Tokoro0917/jansen-mouse/docs/design.md

# 設計資料

## 1. コンセプト

マイクロマウスは通常タイヤ走行ですが、本機はテオヤンセン機構の脚で歩きます。
速さではなく「脚で迷路を解く」ことが目標です。そのため設計方針は次の 3 点です。

1. **旋回するときだけ区画中心で止まる走行**。直進が続くあいだは止まらずに次の区画の壁を先読みし、
   曲がるときは区画中心で止まって前壁補正 → 超信地旋回する。最短走行では直線区間をまとめて走る。
2. **向きはジャイロ、距離はクランク回転数**。脚は横滑りするため車輪型のオドメトリ（左右差から角度）は使わない。
3. **超信地旋回**（左右のクランクを逆回転）。テオヤンセン機構はクランクを逆転すると足先軌跡を逆にたどるので後退・旋回が可能。

## 2. 脚機構

### 2.1 リンク寸法

Theo Jansen の Holy Numbers を縮尺 `s` [mm/unit] で縮小して使います。

| 項目 | Holy Numbers 基準 (s = 1) | 本機 (s = 0.40) |
|---|---|---|
| クランク半径 m | 15 | 6.0 mm |
| 1 本の足の接地区間の長さ | 53.1 | 21.2 mm |
| **1 回転あたりの胴体の前進量**（片側 3 スロー） | 136.1 | **54.4 mm** |
| 足上げ高さ | 22.5 | 9.0 mm |
| クランク中心の対地高さ | 91.8 | 36.7 mm |
| 接地区間の平坦度 | 0.67 | 0.27 mm |

全リンク長は [jansen_report.md](jansen_report.md) を参照（自動生成）。

### 2.2 組立クランク軸と積層順

リンク j, k は回転中にクランク中心 O の真上を通過するため、**脚の層を貫く通し軸は置けません**。
そこで 1 スロー（前脚 + 鏡像の後脚）ごとに、2 枚のクランクウェブの間にクランクピン A だけを渡す
**組立クランク軸**にしています（自転車のクランクと同じ考え方）。

```
フレーム板 | ウェブ | 脚の層 1〜5 | ウェブ | フレーム板 | ウェブ | 脚の層 1〜5 | ウェブ | フレーム板 | ウェブ | 脚の層 1〜5 | ウェブ | フレーム板
           └──────── スロー 1 ────────┘            └──────── スロー 2（120°）────────┘            └──────── スロー 3（240°）────────┘
```

- 板と板の間には、フレーム板とウェブの間も含めてすべて 0.3 mm のワッシャが入る。1 モジュールの厚さは
  板 8 枚（フレーム板 1・ウェブ 2・脚 5）+ ワッシャ 8 枚 = 8 × 1.8 = 14.4 mm（`assembly.module_thickness`）。
- モジュール間は 3 mm 六角シャフトでつなぎ、ウェブの六角穴で位相（60° 刻み、本機は 120° ずつ）を決める。
- 固定ピン B / B' はフレーム板から片持ちで立てる。
- 部品の層は `mechanism/jansen/assembly.py` が自動で決める。クランク 1 回転を 72 姿勢に分け、
  「同じ層の部品同士が 0.6 mm 以内に近づかない」「部品が自分の付いていないピンを横切らない」条件で
  層数最小の割り当てをバックトラック探索し、さらに独立した検査関数で再確認している。

| 層 | 部品（' は後脚） |
|---|---|
| 1 | T', k |
| 2 | U, k' |
| 3 | T, U', j |
| 4 | c, c', j' |
| 5 | f, f' |

（U = 上三角形 b-d-e、T = 足三角形 g-i-h）

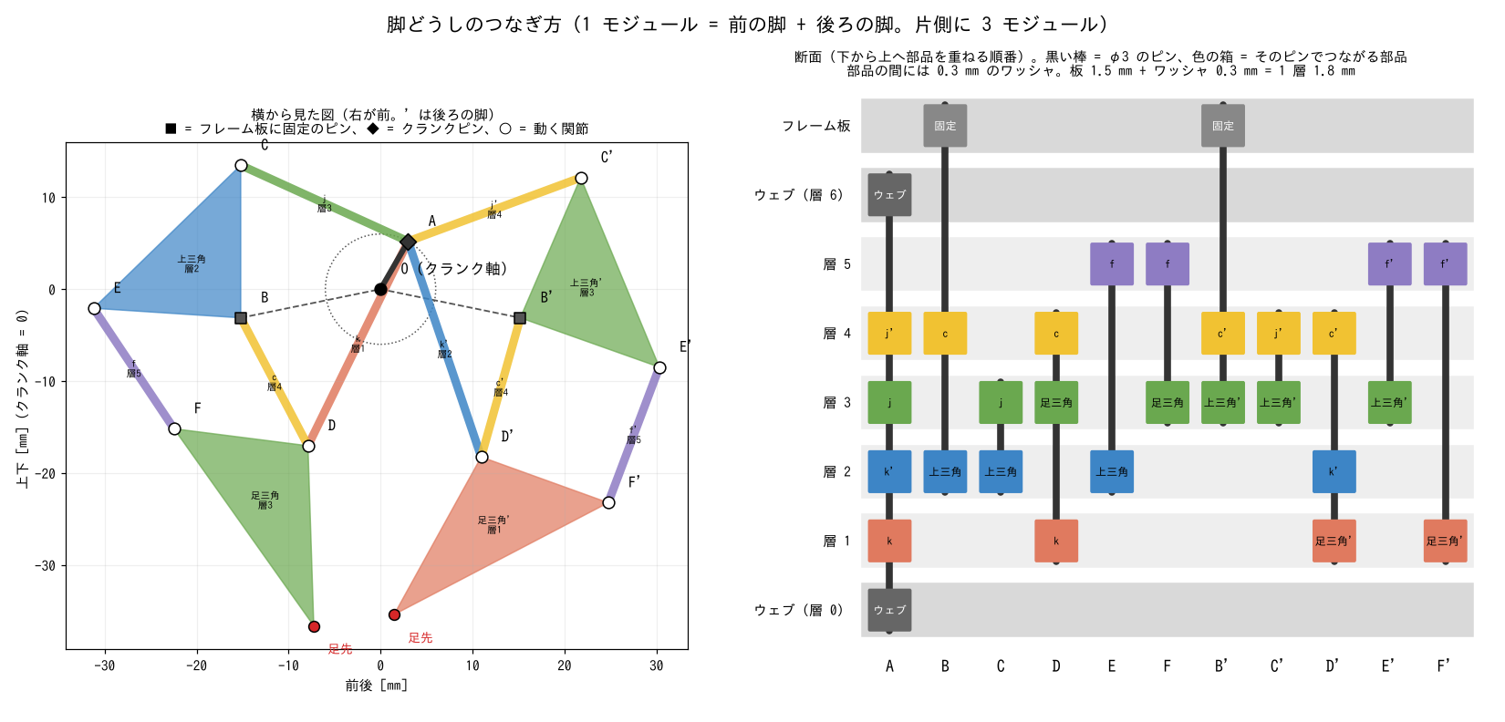
[picture p3: docs/images/joints.png]
脚どうしのつなぎ方


前の脚と後ろの脚が共有するのは、クランクピン A（j・k・j'・k' の 4 本がつながる）と、フレーム板の固定ピン B / B' だけです。
ピン・スリーブ・ワッシャの寸法と数は [parts_list.md](parts_list.md)（自動生成）。

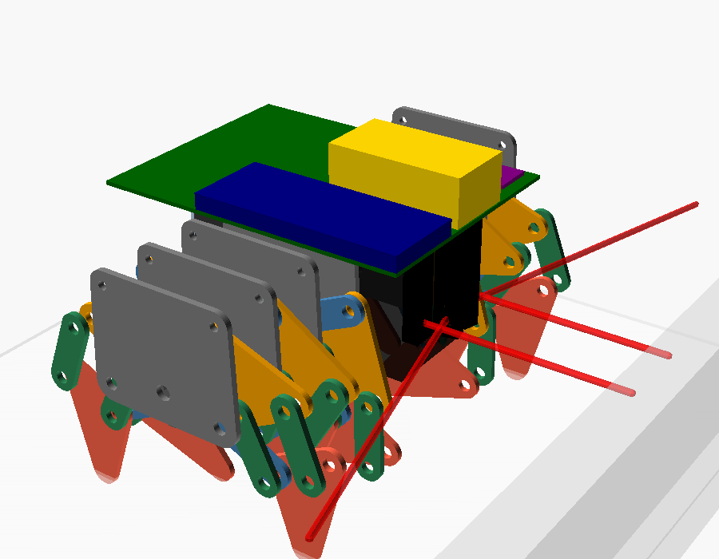
[picture p4: docs/images/assembly.png]
組立図


### 2.3 縮尺・脚の本数・板厚の決め方

クラシックマウスの通路幅は 168 mm（区画 180 mm − 壁厚 12 mm）。区画中央で超信地旋回するには、
**機体中心から最も遠い点までの距離（旋回半径）が、壁までの 84 mm より小さい**必要があります。
位置ずれを見込み、余裕 10 mm 以上を条件にしました。旋回半径は、干渉チェック済みの積層から求めた
脚・フレームの実際の形で計算しています（外接長方形の対角で見積もると、厳しく出すぎる）。

（ワッシャ 0.3 mm、中央部 26 mm。`python -m jansen.cli footprint` で再生成できます）

| 脚の数 | 縮尺 | 板厚 | 全長 | 全幅 | 旋回半径 | 壁までの余裕 | 胴体の上下動 | 1 回転の前進量 |
|---|---|---|---|---|---|---|---|---|
| 8 | 0.35 | 2.0 | 82.0 | 103.6 | 64.3 | +19.7 | 0.51 | 44.1 |
| 8 | 0.35 | 1.5 | 82.0 | 86.6 | 58.3 | +25.7 | 0.51 | 44.1 |
| 8 | 0.40 | 2.0 | 92.7 | 103.6 | 67.8 | +16.2 | 0.58 | 50.5 |
| 8 | 0.40 | 1.5 | 92.7 | 86.6 | 62.2 | +21.8 | 0.58 | 50.5 |
| 8 | 0.45 | 2.0 | 103.4 | 103.6 | 71.6 | +12.4 | 0.65 | 57.0 |
| 8 | 0.45 | 1.5 | 103.4 | 86.6 | 66.3 | +17.7 | 0.65 | 57.0 |
| 12 | 0.35 | 2.0 | 82.0 | 140.4 | 79.3 | +4.7 | 0.03 | 47.4 |
| 12 | 0.35 | 1.5 | 82.0 | 115.4 | 69.3 | +14.7 | 0.03 | 47.4 |
| 12 | 0.40 | 2.0 | 92.7 | 140.4 | 82.2 | +1.8 | 0.03 | 54.5 |
| **12** | **0.40** | **1.5** | **92.7** | **115.4** | **72.6** | **+11.4** | **0.03** | **54.5** |
| 12 | 0.45 | 2.0 | 103.4 | 140.4 | 85.4 | -1.4 | 0.03 | 61.5 |
| 12 | 0.45 | 1.5 | 103.4 | 115.4 | 76.2 | +7.8 | 0.03 | 61.5 |
| 16 | 0.35 | 2.0 | 82.0 | 177.2 | 95.5 | -11.5 | 0.03 | 47.3 |
| 16 | 0.35 | 1.5 | 82.0 | 144.2 | 81.4 | +2.6 | 0.03 | 47.3 |
| 16 | 0.40 | 2.0 | 92.7 | 177.2 | 98.0 | -14.0 | 0.03 | 54.5 |
| 16 | 0.40 | 1.5 | 92.7 | 144.2 | 84.2 | -0.2 | 0.03 | 54.5 |
| 16 | 0.45 | 2.0 | 103.4 | 177.2 | 100.6 | -16.6 | 0.03 | 61.7 |
| 16 | 0.45 | 1.5 | 103.4 | 144.2 | 87.3 | -3.3 | 0.03 | 61.7 |

- **片側 3 スロー（12 脚）・縮尺 0.40・板厚 1.5 mm を採用**（前の構成は 8 脚・縮尺 0.45・板厚 2 mm）。旋回の余裕は 8 脚のとき（12.4 mm）とほぼ同じ 11.4 mm で、
  胴体の上下動が 0.65 → 0.03 mm と約 1/20 になる。
- 12 脚は板厚 2 mm だと幅が 140 mm になり、どの縮尺でも余裕が 5 mm 以下になる。板厚を 1.5 mm にして幅を 115 mm に収めた。
- 片側 4 スロー（16 脚）は、板厚 1.5 mm でも余裕が 2.6 mm 以下で不採用。
- 全長は膝関節 F の振り出し（クランク中心から 59 unit）で決まる。足先の範囲だけで見積もると過小評価になる。

> 経緯: 当初は「縮尺 0.55・片側 3 スロー」と見積もったが、膝関節の振り出しと積層厚を正しく計算すると収まらず、
> いったん 8 脚（縮尺 0.45・板厚 2 mm）にした。その後、旋回半径を実際の形で計算し直し、板厚を 1.5 mm にすれば 12 脚が収まることが分かった。

### 2.4 脚の本数と位相

`support_analysis` による比較（片側あたり）:

| クランクスロー数 | 脚数（片側） | 最小接地脚数 | 胴体の上下動 |
|---|---|---|---|
| 2（前の構成、s = 0.45） | 4 | 2 | 0.65 mm |
| **3（採用、s = 0.40）** | **6** | **2** | **0.03 mm** |

3 スロー（120° 位相）にすると胴体の上下動がほぼ消え、壁センサの値が安定し、前後の滑りも減ります
（前進量の 24 % → 17 %）。旋回中も各側 2 脚以上で支えます。壁の有無は止まらずに歩きながら読みますが、
閾値との差が大きいので誤りません（走行シミュレーションで確認）。

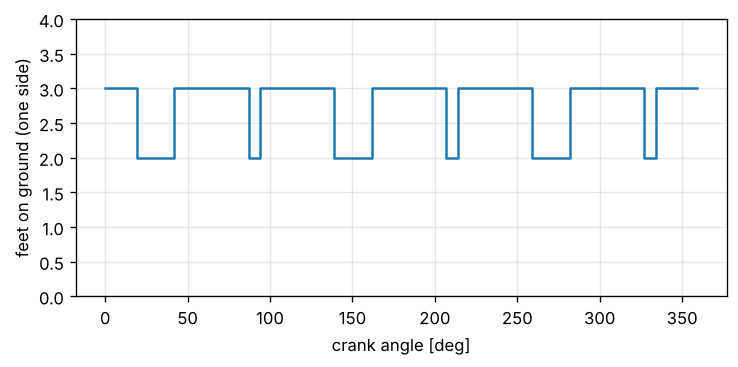
[picture p5: docs/images/contacts.png]
接地数


### 2.5 座標系と回転方向

`mechanism/jansen/linkage.py` では脚が −x 側に伸びる向きで計算しています。
クランクを反時計回り（+θ）に回すと接地中の足先は +x 方向へ動き、機体は −x 方向へ進みます。
実機では左右のモータ向きが鏡像になるため、前進でエンコーダが増える向きを `config.h` の `kMotorLSign / kMotorRSign` で合わせます。

## 3. レギュレーション適合（クラシック競技）

ニューテクノロジー振興財団の[クラシックマウス競技規定](https://www.ntf.or.jp/?page_id=118)（2022 年 6 月 1 日改定）と、
[全日本大会の運営に関する注意事項](https://www.ntf.or.jp/?page_id=124)（2024 年 12 月 7 日改定）による（2026 年 10 月に確認）。

| 項目 | 規定 | 本機 |
|---|---|---|
| 大きさ | 1-5 床面への投影が 1 辺 25 cm の正方形に収まる。高さの制限はない | 93 × 115 mm、高さ約 77 mm |
| 迷路 | 2-2 区画 18 cm × 18 cm、16 × 16 区画。壁の高さ 5 cm、厚さ 1.2 cm | この寸法で設計・シミュレーション |
| 格子点（柱） | 2-4 1.2 cm × 1.2 cm | 同上 |
| 色 | 2-1 壁の側面は白、上面は赤、床面は黒 | 壁センサは白い側面を見る（光の高さ 42 mm） |
| 壁を越えない・壊さない | 1-4 | 足は床面のみを移動。足先にゴムを貼る |
| 終点の通過 | 3-7 床面より 5 cm 以内の部分がすべて終点の区画に入ったとき | 5 cm 以内の部分は前後 93 mm に収まる |
| **持ち時間** | 規定 3-6 は 7 分・5 回。**全日本大会は 5 分・5 回**（運営に関する注意事項 第 5 条） | **探索に 3〜12 分かかる（下の「探索時間の短縮」）** |

> 出場する大会ごとに、最新の規定と運営の注意事項を確認してください。

### 壁センサの位置

壁の高さは 50 mm、クランク中心は地上 41 mm です。脚は機体中心から左右 13〜51 mm の範囲を床から高さ 60 mm 付近まで掃引するので、
壁センサは脚が占めない場所に置く必要があります（[hardware.md](hardware.md#脚が占めない場所に部品を置く)）。

- 4 本とも基板（1 枚、脚の上）の前端より内側の裏に、縦長のホルダで下げる（KOGUMA Mk4 と同じ考え方）。光の高さは地上 42 mm。
  前に突き出す所はない
- 前壁センサ（FL / FR）: 中央の溝の端（左右 ±9 mm、前 34 mm）、真正面向き
- 左右壁センサ（L / R）: 内側（左右 ±5 mm、前 37 mm）から斜め前 75° に向け、FL / FR のホルダの前を通して横の壁を見る。
  光の高さでは脚は前後 33 mm までしか来ないので、それより前から光を出せば斜めでも脚に当たらない

## 4. 制御

```
1 kHz タイマ割り込み (Motion::tick)
 ├─ エンコーダ → クランク回転速度（ローパス）
 ├─ ジャイロ Z → ヨー角を積分
 ├─ 壁センサ（対角の 2 個ずつ FL・R / L・FR を交互に、点灯−消灯の差分）
 └─ モード別指令
     直進: 台形プロファイル v(t) + 向き保持(ジャイロ) + 左右壁で中央寄せ
     旋回: 台形プロファイル ω(t) + 角速度・角度のフィードバック
     前壁補正: FL+FR で距離、FL−FR で向きを合わせ、基準方位を更新
 → 左右クランク目標回転数 = (v ∓ ω·T/2) / 1 回転あたりの前進量
 → クランク速度 PID + フィードフォワード → PWM
```

- 歩行は 1 回転の中で速度が周期的に揺れるので、速度・センサ値には強めのローパス（α = 0.05）をかけています。
- 走行距離 = クランク回転数 × 1 回転あたりの前進量 × `kTravelCorrection`。滑りによる誤差はモード 3 で較正します。
- 前壁がある区画で旋回する前に前壁補正を行い、蓄積した距離・角度誤差をリセットします。
  前壁と直角になった時点でジャイロの向きの推定値を理想の向きに戻し、ドリフトも消します。
- 直進は速度プロファイルに**エンコーダ距離のフィードバック**を加え、目標距離に達するまで終わりません。
- 左右壁による中央寄せには積分動作（`wall_trim_`）を持たせ、ジャイロのドリフトで向きの基準がずれても壁に合わせて直します。
- **壁切れ**（横壁が途切れる瞬間）で走行距離を補正します。直進は必ず区画中心から始まるので、
  壁切れが起きる距離は「k × 180 mm + (90 + 6 − センサ前後位置) mm」に決まります。
- 両側に壁が続く通路では壁切れがないので、前壁がある場合は**前壁センサが区画中心の値に達した時点で止まります**。
- 旋回は目標角との差が 0.5° 未満・角速度 5 deg/s 未満になるまで続けます。
  足の横滑りで旋回の実効が落ちるため、旋回の角度ゲイン（`kTurnAngleKp`）は直進より強くしています。

## 5. 迷路アルゴリズム

- **探索**: 足立法。未知の壁は「無い」とみなした歩数マップで、最も歩数の小さい隣接区画へ進む。同点なら直進優先（脚機構は旋回が遅いため）。
  ゴール（中央 4 区画）到達後、同じ方法でスタートへ戻る。
- **最短走行**: 既知の壁のみ（未知は「有る」とみなす）で歩数マップを作り、連続する直進をまとめた動作列を生成。
- PC 上の試験（`firmware/test/test_maze`）で、ループを含むランダム迷路 30 面について
  「ゴール到達 → 帰還 → 既知壁のみの最短経路が真の迷路上で壁に衝突しない」ことを確認しています。

## 6. 駆動とモータ

`mechanism/jansen/drive.py` の解析結果です（`python -m jansen.cli report` で再生成できます）。

### 6.1 1 回転あたりの前進量

**1 回転で進む距離は「1 本の足の接地区間の長さ（21.2 mm）」ではありません。**
複数の脚が交代で胴体を支えるので、胴体は常に「接地中の足の速度」で進みます。
そのため 1 回転の前進量は ∫ v_接地足 dθ = **54.4 mm** になり、1 区画は 3.31 回転です（12 脚・縮尺 0.40）。

- 前進量の求め方は、速度を積分する方法と、接地足の位置を追う方法の 2 通りで計算し、10 % 以内で一致することをテストで確認しています。
- 1 回転の中で胴体の速度は ±10 % 揺れます（8 脚のときは ±27 %）。回転角から距離を直線で求めたときの誤差は最大 0.61 mm で、対応表を持つ必要はありません。
- 同時に接地している足の速度が食い違うため、前進量の 17 % 程度は足が床を擦って滑ります（8 脚のときは 24 %）。
  モデルは「胴体は接地足の平均速度で進む」としています。実機ではずれが出るので、モード 3 で補正します。

> 当初のファームは接地区間の長さ（当時の構成で 23.9 mm）を 1 回転の前進量に使っていたため、1 区画のつもりで約 2.4 区画進んでしまう状態でした（修正済み）。

### 6.2 必要なトルクと回転数

前提: 機体 200 g、足（ゴム）と床の摩擦係数 0.6、関節の摩擦をまとめた効率 0.6。

| 動作 | 片側クランクの最大トルク | 必要なクランク回転数 |
|---|---|---|
| 直進（最短走行 500 mm/s） | 2.6 N·mm | 551 rpm |
| 直進（探索 90 mm/s） | 2.6 N·mm | 99 rpm |
| 超信地旋回（180 deg/s） | 6.5 N·mm | 122 rpm |

- 直進では、トルクのほとんどが足の前後の滑りに使われます（12 脚では胴体の上下動がほぼないため、8 脚より軽い）。
- 旋回では、脚が足を横に動かせないため、接地足がクランク軸からの前後距離 |x| に比例して横に滑ります。これが直進の約 2.5 倍の負荷になります。
- 12 脚にして左右の脚群の間隔が広がった（64 → 71 mm）ので、同じ旋回速度に必要なクランク回転数が増えました。
- 速い回転が要るのは直進（トルクは小さい）、大きいトルクが要るのは旋回（回転は遅い）なので、
  モータの要求は動作点ごとに考える: **直進 500 mm/s で 551 rpm @ 2.6 N·mm、旋回で 122 rpm @ 6.5 N·mm**。
- 摩擦係数・関節効率は仮定値です。試作後に電流値（トルク）を測って見直してください。

### 6.3 モータの選定

最短走行で 500 mm/s を出すため、**N20 ウォームギヤモータ（出力軸が直交）6 V 高出力巻線（B45）42:1** を 2S で直接駆動する。
カタログ（6 V）: 無負荷 530 rpm、定格 390 rpm @ 0.06 kgf·cm、停動電流 0.65 A 以下、約 15 g。
トルク-回転数を直線とし、回転数と停動トルクが電圧に比例するとして見積もった（`jansen/drive.py` の `MotorSpec`）。

| 電池の電圧 | 直進の最高速度（見積りのトルク / その 3 倍） | 旋回の負荷 3 倍での回転数（要求 147 rpm） |
|---|---|---|
| 7.4 V（2S 公称） | **537** / 424 mm/s | 189 rpm |
| 8.4 V（2S 満充電） | 617 / 504 mm/s | 277 rpm |

- 見積りのトルクなら公称電圧で 500 mm/s を超える。トルクが見積りの 3 倍だと公称電圧では届かず、約 420 mm/s になる。
- 旋回は負荷 3 倍でも足りる。停動トルクは旋回の最大トルクの約 4 倍。停動電流は満充電で約 0.9 A で、DRV8835（1.5 A / ch）以内。
- 定格 6 V のモータを 2S（7.4〜8.4 V）で回す。500 mm/s ではモータにかかる平均電圧が約 7 V になる。
- 比べた候補: 同じモータの 118:1 は旋回トルクに余裕が大きい（停動トルクが約 11 倍）が、直進は 2S で最高 205 mm/s。
  12 V 巻線の品は 2S では遅すぎる。
- 42:1 のウォームは、118:1 と違って脚の側から押されると回る（セルフロックしない）かもしれない。
- エンコーダはクランク 1 回転あたり 1176 count（0.046 mm / count）。
- **シミュレーションに入っていないこと**: クランク毎秒 9 回転で歩くときの脚の慣性、足が床に当たる衝撃・跳ね、
  速いときの足の滑りの増え方。モータが届いたら、まず片側の脚だけで速度を上げていく試験をして、500 mm/s で歩けるかを確かめる。

## 7. 走行シミュレーション

`firmware/test/test_sim` で、実機と同じ走行制御・探索コード（`lib/mouse`）を模擬ロボット上で 1 kHz で動かします。

| 模擬するもの | モデル |
|---|---|
| モータ | duty → クランク角速度の 1 次遅れ（30 ms） |
| 歩行 | 胴体速度 = クランク角速度 × 胴体速度表（`mechanism_params.h`、1 回転内の ±27 % の揺れ）× 前進量の誤差 |
| 旋回 | 左右の速度差から。足の横滑りで実効 75 % |
| 外乱 | 歩行中のランダムなヨー、ジャイロのバイアス 0.2 deg/s とノイズ |
| 壁センサ | 機体設計どおりの位置から、壁・柱（12 mm 角）へのレイキャストで距離 d を求め、4000 × (r0 / d)² の ADC 値 + ノイズ（r0 = 30）。対角の 2 個ずつ交互に更新 |
| 衝突 | 機体外形（脚の掃引範囲、`mechanism_params.h` の全長 × 全幅）が壁・柱に入ったら記録 |

### 見つかって直したファームの不具合

| 不具合 | 症状 | 修正 |
|---|---|---|
| 前壁補正の回転方向が逆 | 傾きを補正するつもりで逆に回し、その向きを基準にしてしまう | 符号を修正。補正後はジャイロ推定値を理想の向きに戻す |
| 直進の距離が時間で決まっていた | 速度追従の遅れがそのまま距離誤差になる | エンコーダ距離のフィードバックと完了判定を追加 |
| ジャイロのドリフトに中央寄せが負ける | 1 区画あたり約 3 mm 横にずれていく | 中央寄せに積分動作を追加 |
| 旋回が目標角に届かない | 足の滑りで 1 回あたり約 3° 不足（時間切れで終了） | 旋回専用の角度ゲインと、収束を待つ完了判定 |
| 前進量の誤差が蓄積 | 両側に壁が続く通路で 1 区画 5 mm ずつ行き過ぎ、前壁に衝突 | 壁切れによる距離補正と、前壁での停止 |
| 最短走行で前壁補正をしない | 誤差が蓄積して衝突 | 旋回前に前壁補正 |

### 結果

前進量の誤差 0 / ±3 % を含むランダム迷路 16 面で、探索（スタート → ゴール → スタート）と最短走行を行い、
**衝突 0 回・壁の誤検知 0 件**、スタートへの戻り位置のずれ 1〜14 mm でした。

左右センサの向きによる比較（迷路 4 面）:

| 向き | 結果 |
|---|---|
| 60°（斜め前） | 壁のない区画で隣の柱を壁と誤検知し、探索が行き詰まる |
| 75° | 探索は成功するが、最短走行で衝突 |
| 90°（真横） | 全て成功 |

この比較は、ファームが「左右センサは真横向き」と決めつけていたときのもの（光が壁に当たる点と、光の長さの差を横ずれに直す係数が合っていなかった）。
ファームを斜めの向きに合わせた（壁切れ・横壁の読み取りを「光が壁に当たる点」で考え、光の長さの差に sin(向き) を掛けて横ずれにする）あとは、
**75° で迷路 16 面すべて衝突 0・誤検知 0**、探索・最短走行の時間も真横（x 60）のときと同じ（探索の合計 9553 秒 / 9555 秒）でした。
いまの配置は 75° です（センサを基板の前に突き出さずに済むため）。

### 探索時間の短縮

当初は区画ごとに止まって壁を見る方式（探索速度 60 mm/s）で、探索（往復）に最長 982 秒かかっていました。
次の 3 つで短縮し、迷路 16 面の合計を 24 % 減らしました（衝突・壁の誤検知は 0 のまま）。

1. **直進中は止まらない**: 次の区画の中心の 20 mm 手前で、その区画の前壁を先読みし、直進を続けるなら直進を延長する。
   曲がるときだけ区画中心で止まる。横壁はそれより手前、左右センサの光が次の区画の横壁の真ん中に当たる瞬間に読んでおく。
2. **探索速度を 90 mm/s に**（クランク 99 rpm。モータの能力の 2 割以下）。
3. **帰り道は最短経路が確定したら探索をやめる**: 未知の壁を「無い」とみなした最短距離と、既知の壁だけの最短距離が
   等しくなったら、それ以上探索しても最短走行は短くならないので、既知の道でスタートへ戻る。
   シミュレーションでは、探索をやめた時点の既知の最短経路が真の最短経路と同じ長さであることも確認している。

| 方式（12 脚・壁センサ斜め 75° の機体） | 迷路 16 面の合計 | 最短 | 最長 | 5 分以内の迷路 |
|---|---|---|---|---|
| 区画ごとに停止・60 mm/s（当初） | 9553 秒 | 247 秒 | 982 秒 | 2 / 16 |
| 直進中は止まらない・90 mm/s・帰り道の早期終了（加速度 150 mm/s²） | 7269 秒 | 193 秒 | 746 秒 | 3 / 16 |
| **同・加速度 1500 mm/s²（採用。42:1 のモータ）** | **6786 秒** | **180 秒** | **691 秒** | **4 / 16** |

- 時間は探索の往復だけ。最短走行は含まない。
- 最短走行（500 mm/s、加速度 1500 mm/s²）は 16 面の合計 1180 秒、1 面 25〜174 秒（90 mm/s のときは合計 2077 秒）。
  最高速度を 5.5 倍にしても半分ほどにしか縮まないのは、旋回（1 回 1.5 秒前後）が多くを占めるため。
- **全日本大会の持ち時間は 5 分**なので、多くの迷路ではまだ探索の途中で時間切れになる。
- 残りの時間の多くは旋回（前壁補正 0.4 秒 + 旋回約 1 秒 + 静定）。次の短縮は、旋回を減らす走り方、
  または探索をゴールまでにして帰りは探索しないこと。
- 帰り道の早期終了は、これらの迷路ではほとんど効いていない（最短経路が確定するのが帰り道の終盤のため）。

## 8. 機体設計

部品の配置は `mechanism/jansen/body.py` にまとめ、次を自動で検証しています（`python -m jansen.cli body`、`pytest`）。

| 検証 | 結果 |
|---|---|
| 部品と脚の掃引域・フレーム板の干渉 | なし |
| 壁センサの光（半角 10° の円すい、区画中心にいるとき壁面まで）を遮るもの | なし |
| 超信地旋回の半径 | 72.6 mm（壁まで 84 mm） |
| 重量 | 約 200 g（駆動トルクの見積もりの前提と一致） |
| 重心 | 前後 0.0、左右 0.0、高さ 42 mm（電池の位置を計算で決めて機体の中心に合わせる） |
| 横方向の転倒角 | 36°（最も内側の脚だけが接地する瞬間で評価） |

検証で分かったこと:

- **以前の壁センサの配置は脚の掃引域の中で、物理的に成り立たなかった**（4 つとも光路が脚に遮られる）。
  KOGUMA Mk4 を参考に、4 本を 1 枚の基板の前の端の裏に下げた（[hardware.md](hardware.md#壁センサkoguma-mk4-を参考にした)）。
- センサの配置を変えるたびに走行シミュレーションで見つかったファームの不具合:
  - 壁に近いセンサは値の変化が大きく、中央寄せが発振した → センサ値を距離（mm）に換算してから制御に使う（値はほぼ距離の 2 乗に反比例）
  - 柱（12 mm 角）を一瞬だけ壁として見て、中央寄せが反応した → 25 mm 以上続けて見えた壁だけを使う
  - 壁の終わりで値が下がると、距離に換算した横ずれが大きくなり急に曲がった → 横ずれを ±10 mm に制限し、区画中央の値の 30 % 未満は使わない
  - 前壁補正が時間で打ち切られて傾きが約 25 % 残り、それをジャイロの基準にしていた → 傾き・距離が収まるまで続ける
  - 左右センサの光は機体中心より前の壁に当たるので、行き過ぎると次の区画の壁を見る → 前進の途中で、光が次の区画の横壁の真ん中に当たる瞬間に横壁を読む
- これらの修正後、走行シミュレーション 16 面（前進量の誤差 ±3 % を含む）を衝突・誤検知なしで完了。

基板は 1 枚で、脚の上（高さ 64 mm）に置いています。迷路の壁は高さ 50 mm（競技規定）なので、
壁センサは KOGUMA Mk4 と同じホルダを縦に長く（26.7 mm）して基板の前端より内側の裏から下げ、光の高さを 42 mm にしています。
左右センサを斜め前 75° に向けたので、センサのために基板を前へ突き出す必要はありません。
重心は、一番重い電池の位置を計算で決めて、機体の中心（前後・左右とも 0）に合わせています。

経緯: 最初は脚の上にメイン基板、脚の前に別の壁センサ基板を置き、溝を埋める中央シャーシ（約 19 g）で支えていた。
シャーシを必要な所だけのブリッジ（約 7 g）にし（211 → 199 g）、基板を 1 枚にまとめた。
基板を中央の溝の中（モータの上）に置く案（185 g、高さ 62 mm）も試したが、溝の幅が 25 mm しかなく部品の置き場所が
限られるので、脚の上に戻し、壁センサのホルダを縦に長くした。
最後に、左右の壁センサを真横から斜め前 75° に変え、センサのために基板の前に出していた舌（24 × 25 mm）をなくした（全長 110 → 93 mm）。

モータの外形（12 x 14 x 41 mm）と重量は代表的な値の仮定です。購入したら `body.py` の値を実測値に直して再検証してください。
