Tokoro0917/jansen-mouse/docs/hardware.md

# ハードウェア

## 部品表（1 台分の目安）

機構部品（板・ピン・スリーブ・ネジ）の寸法と数は [parts_list.md](parts_list.md)（自動生成）。

| 区分 | 部品 | 数量 | 備考 |
|---|---|---|---|
| マイコン | WeAct Black Pill (STM32F411CEU6) | 1 | 100 MHz, USB CDC でログ出力。ピンヘッダなしで基板に直付け |
| モータ | **N20 ウォームギヤモータ（出力軸が直交）、6 V 高出力巻線（B45）、減速比 42:1、磁気エンコーダ 7 PPR**（例: NFP-GW12T-N20YZ-EN 系。6 V で無負荷 530 rpm、定格 390 rpm @ 0.06 kgf·cm、停動電流 0.65 A 以下、約 15 g） | 2 | 2S で直接駆動し、直進 500 mm/s を狙う（[design.md](design.md#63-モータの選定)）。7 PPR × 4 逓倍 × 42 = 1176 count / クランク 1 回転。中央の溝（幅 26 mm）に 2 個並べるので、**ギヤボックスの出力軸方向の厚みが 12 mm 以下であることと、エンコーダが付いていることを購入前に確認**。外形 12 × 14 × 41 mm は仮定なので、図面が手に入ったら `jansen/body.py` を直す |
| モータドライバ | DRV8835 | 1 | MODE=High（PHASE/ENABLE） |
| ジャイロ | ICM-20602 または MPU-6500（SPI） | 1 | ±2000 dps で使用 |
| 壁センサの発光 | OPV332（φ3 の赤外 LED） | 4 | KOGUMA Mk4 と同じ |
| 発光の定電流ドライバ | NJU6080（SOT-23-6）、電流設定 20 Ω（10 mA）、パスコン 100 nF | 各 4 | 1 個ずつ駆動し、電源は 3.3 V。電池（2S）の電圧が変わっても発光の強さが変わらない |
| 壁センサの受光 | SFH 229 FA（フォトダイオード） | 4 | KOGUMA Mk4 と同じ |
| 受光アンプ | OPA2354（2 回路入り）、帰還 820 kΩ + 0.5 pF、+ 側に PD_BIAS 約 0.15 V | 2 | 電流-電圧変換。整定 約 2 µs（Mk4 の 2026-10-29 の値。浮遊容量が効くので実機で波形を見て決める） |
| 壁センサのホルダ | 光を通さない黒い樹脂（光造形）、6.0 × 4.04 × 26.7 mm（縦長） | 4 | `sensor_holder()`。KOGUMA Mk4 / ToraNeko.Mk3 と同じ考え方で発光と受光を縦に重ね、基板の裏に下げる。基板が脚の上にあるので、壁より下に光を出すため縦に長くした。後ろの面の溝に足を沿わせる（足が短ければ線を継ぐ） |
| 電源 | 2S LiPo 7.4 V 200 mAh（約 34 x 18 x 12 mm、13 g） | 1 | 3.3 V は Black Pill のレギュレータ、または別途 LDO |
| 基板 | 1 枚、80 x 60 mm、t1.0（前に突き出す所なし） | 1 | 外形は `deck_outline()` を DXF で出力（ホルダのほぞの穴を含む）。マイコン・ドライバ・IMU・電池・壁センサの回路を全部載せる |
| UI | タクトスイッチ 2、圧電ブザー 1 | | |
| 脚 | 1.5 mm 厚 板（POM / アクリル のレーザー加工） | 12 脚分 | `cad/parts.scad`。12 脚を通路幅に収めるため 1.5 mm（[design.md](design.md#23-縮尺脚の本数板厚の決め方)）。試作は 3D プリントでも作れる（[printing.md](printing.md)） |
| クランク軸 | クランクウェブ 12 枚（うち 2 枚はモータ軸用 `web_motor()`）、φ3 クランクピン 6 本、3 mm 六角シャフト 4 本 | | 六角穴で位相（120° ずつ）を合わせる |
| フレーム | フレーム板 8 枚（1.5 mm 厚）、M2 全ねじ 2 本（約 120 mm）、スペーサ（スリーブ） | | `frame()`。全ねじが左右すべての板と中央の溝のスリーブを貫き、外側からナットで締める |
| ブリッジ | 3D プリント（PLA）、約 7 g | 1 | `bridge()`。左右の脚群をつなぎ、モータを上から押さえ、基板を支える。天板とタイロッドの所のリブだけの形 |
| モータ押さえ | 3D プリント（PLA） | 1 | `motor_clamp()`。モータを下から支え、前後の柱をブリッジにネジ止めする |
| ピン | φ3 mm シャフト + E リング、0.3 mm ワッシャ | 66 | リンク関節（1 モジュール 11 本 × 6） |
| 足先 | ゴムシート / 熱収縮チューブ | 12 | 滑り止め |

> 重量の見積もりは約 200 g（内訳は [jansen_report.md](jansen_report.md#機体の部品配置)）。駆動トルクの見積もりの前提と同じ。

## ピン配置

| 機能 | ピン | 備考 |
|---|---|---|
| 左モータ PWM / DIR | PA8 / PB12 | TIM1_CH1 |
| 右モータ PWM / DIR | PA9 / PB13 | TIM1_CH2 |
| 左エンコーダ A / B | PB4 / PB5 | 外部割り込み |
| 右エンコーダ A / B | PB6 / PB7 | 外部割り込み |
| 壁センサの発光 FL・R / L・FR | PB14 / PB15 | 対角の 2 個ずつの NJU6080 の PWM 端子（Mk4 の WALL_LED_FL_R / WALL_LED_L_FR） |
| 受光 FL / L / R / FR | PA0 / PA1 / PA2 / PA3 | ADC |
| IMU SPI (CS/SCK/MISO/MOSI) | PA4 / PA5 / PA6 / PA7 | SPI1 |
| 電池電圧 | PB1 | 20k / 10k 分圧 |
| ブザー | PA15 | |
| MODE / START ボタン | PA10 / PB3 | 内部プルアップ |
| 状態 LED | PC13 | オンボード |

タイマ: TIM1 = モータ PWM (20 kHz)、TIM10 = `tone()`、**TIM11 = 1 kHz 制御ループ**。

## 機体構成

立体図

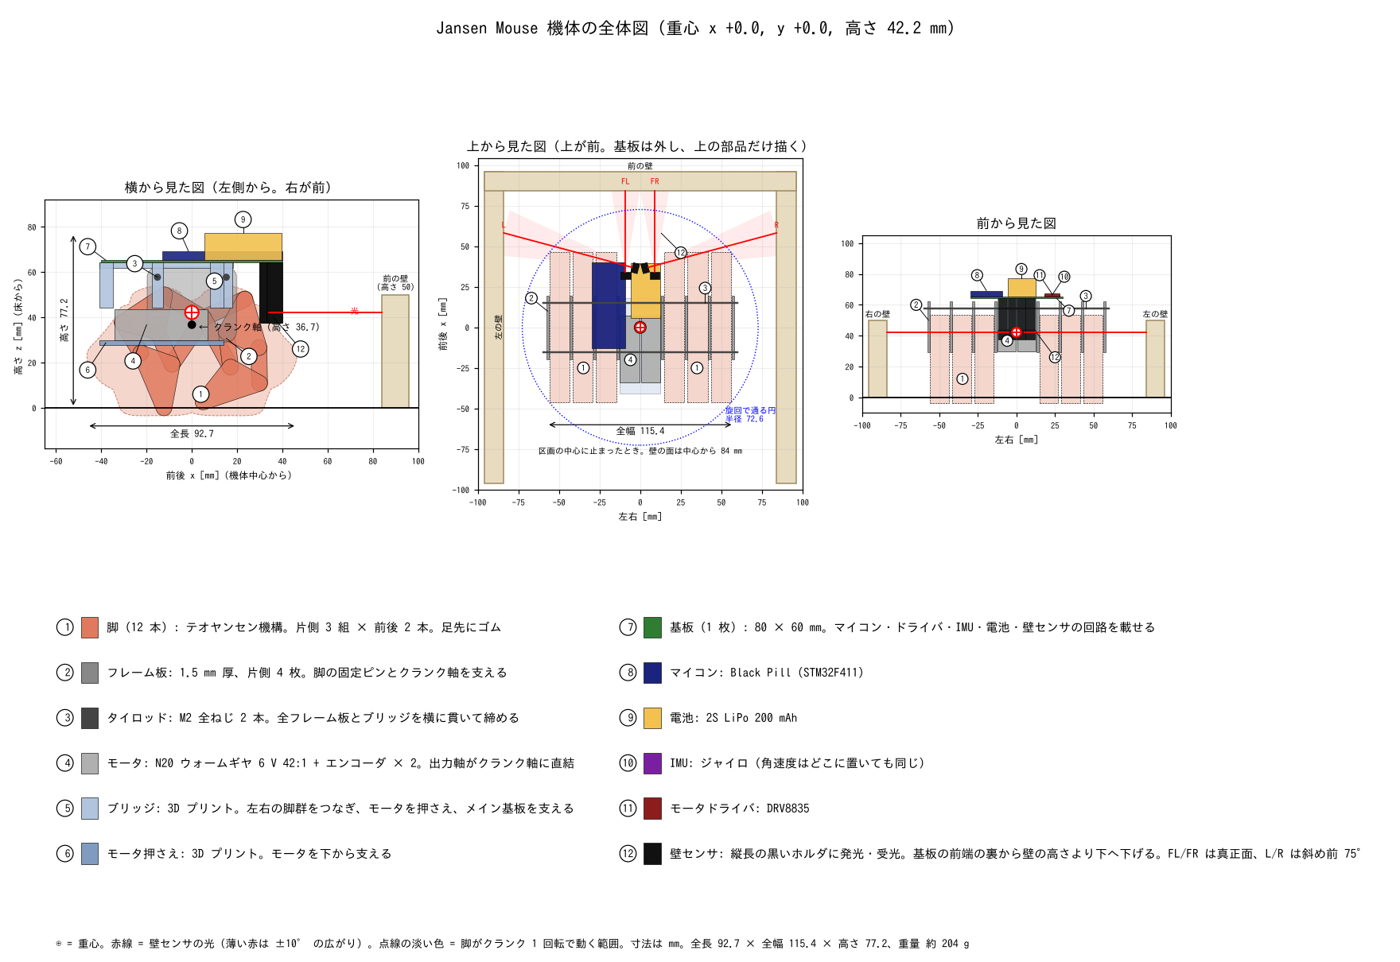
[picture p6: docs/images/overview_views.png]
全体図（部品の説明つき三面図）


（`python -m jansen.cli drawing -o ../docs/images` で三面図を再生成できます）

```
                    前
   ┌────────────────────────────────┐ ← 前端の裏に壁センサ 4 本（縦長のホルダで壁の高さより下へ下げる。
   │        基板 1 枚（脚より上、高さ 64 mm）         │     L / R は斜め前 75°）。電池の位置で重心を機体の中心に合わせる
   ├──────────┬────────────┬──────────┤
   │ 左脚群   │ 中央の溝 26 mm │ 右脚群   │   全長 93 mm × 全幅 115 mm × 高さ 77 mm
   │ 6 脚     │ モータ 2 個    │ 6 脚     │   左右それぞれ: 3 スロー（120° ずつ）
   │ 44 mm    │ ブリッジ       │ 44 mm    │   各スローに前向き脚 + 後ろ向き脚（鏡像）
   └──────────┴────────────┴──────────┘
```

組立図

（赤い線は壁センサの光路。白い板は区画中心にいるときの前壁）

### 基板を 1 枚にする（脚の上）

脚はクランク 1 回転で、機体中心から左右 13〜57 mm の範囲を床から高さ 54 mm 付近まで掃引するので、
基板は脚とフレーム板より上（高さ 64 mm）に 1 枚だけ置き、マイコン・ドライバ・IMU・電池・壁センサの回路を全部載せます。

迷路の壁は高さ 50 mm（[クラシックマウス競技規定](https://www.ntf.or.jp/?page_id=118) 2-2「区画の壁の高さは 5cm、厚さは 1.2cm とする」）なので、
壁センサの光はそれより下に出す必要があります。そこで、KOGUMA Mk4 と同じホルダを**縦に長く（26.7 mm）**して、
基板の前端より内側の裏から下げ、光の高さを 42 mm（壁の上端より 8 mm 下）にしています。
左右センサを斜め前に向けたので、基板は前に突き出しません（全長は脚で決まる 93 mm）。

| 場所 | 置くもの |
|---|---|
| 中央の溝（左右 ±13 mm） | モータ 2 個（クランク軸の高さ）、ブリッジ |
| 脚より上（高さ 64 mm〜） | 基板 1 枚（マイコン・ドライバ・IMU・電池・壁センサの回路） |
| 基板の前端（x 30〜40）の裏 | 壁センサ 4 本（縦長のホルダ） |

- 各側の積層: フレーム板 |（ウェブ | 脚 5 層 | ウェブ | フレーム板）× 3。
  積層順は [design.md](design.md#22-組立クランク軸と積層順) の表のとおり（自動計算・干渉チェック済み）。
- **タイロッド構造**: 2 本の M2 全ねじが、クランク中心から 21 mm 上（脚の最高点 17 mm より上）で左右すべてのフレーム板・スペーサ・ブリッジを貫き、
  最も外側の板の外からナットで締めて全体を一体にする。
- **モータ**: 出力軸がクランク軸と同軸。内側のフレーム板の軸受穴を通って、最も内側のクランクウェブ（`web_motor()`、D カット穴）に直接入る。
  上をブリッジ、下をモータ押さえで挟む。
- **ブリッジ**: 天板（2.5 mm）と、タイロッドの所の 2 枚のリブ、モータ押さえを留める 2 本のボスだけの形（約 7 g）。基板をリブの上にネジ止めする。
- **重心**: 電池（13 g、一番重い部品）の位置を、ほかの部品の重さから計算して決め、重心を機体の中心（クランク軸の真上、前後左右とも 0）に合わせる。
  脚・フレーム・ピンは左右対称でクランク軸の真下にあるので、基板の上の部品だけで釣り合わせている。部品の重さが変わったら `body.py` が電池の位置を計算し直す。
- 組立図は `cad/assembly_generated.scad`（`python -m jansen.cli assembly --theta 角度` で任意のクランク角を生成）。

検証結果（部品ごとの座標と重量は [jansen_report.md](jansen_report.md#機体の部品配置)）:

| 項目 | 結果 |
|---|---|
| 部品と脚・フレームの干渉 | なし |
| 壁センサの光（半角 10° の円すい）を遮るもの | なし |
| 超信地旋回の半径 | 72.6 mm（壁まで 84 mm、余裕 11.4 mm。基板は機体の中心線近くなので旋回半径を増やさない） |
| 重量 | 約 200 g |
| 重心 | 前後 0.0、左右 0.0（機体の中心）、高さ 42 mm |
| 横方向の転倒角 | 36° |
| 部品の最低地上高 | 30 mm |

### 壁センサ（KOGUMA Mk4 を参考にした）

KOGUMA Mk4（`Tokoro0917/koguma-mk4` の `docs/spec.md`「壁センサ」と `mechanical/sensor_holder/`）から次を取り入れた。

| 項目 | KOGUMA Mk4 | 本機 |
|---|---|---|
| 発光・受光 | OPV332 + 定電流 NJU6080（10 mA）/ SFH 229 FA + OPA2354 の電流-電圧変換 | 同じ |
| 点灯の組み合わせ | 対角の 2 個ずつ（FL・R / L・FR） | 同じ。4 本が 18 mm 四方に集まっているので、隣どうしで光が混ざらないようにする効果が大きい |
| ホルダ | 黒い樹脂、発光を基板から遠い穴・受光を近い穴、基板の裏にさかさま | 同じ（フレームに当てないので足はなし） |
| 4 本の置き方 | 1 枚の基板（メイン基板）にまとめる | 同じ（基板 1 枚の前端より内側の裏） |
| 遮りの確かめ方 | 光を円すいとして機体の部品と照合 | 同じ（半角 10° の円すいで脚・部品と照合） |
| 前の 2 本の向き | 外へ 7°（斜めの走行で柱を見るため） | **真正面**（斜めに走らない。左右の差で前の壁に対する傾きを見る） |
| 横の 2 本の向き | 交差させて、前の柱の前半分を見る | **斜め前 75°**（交差はさせない。区画の中心にいるとき、その区画の横壁の柱から 26 mm 手前を見る） |

| センサ | 位置（機体中心から、ホルダの前の面） | 光の高さ | 向き | 区画中央で壁まで |
|---|---|---|---|---|
| FL / FR | 前 34 mm、左右 ±9 mm（中央の溝の端） | 42.0 mm | 真正面 | 50 mm |
| L / R | 前 37 mm、左右 ±5 mm（FL / FR の内側） | 42.0 mm | **斜め前 75°** | 82 mm（光が壁に当たる点は機体中心の 58 mm 前） |

- 光の高さでは、脚は前後 33 mm までしか来ない。4 本ともそれより前（x 34〜37）から光を出すので、円すいの光も脚に当たらない。
  L / R は内側から斜めに出し、FL / FR のホルダの前を通す。斜めにしたので、真横向きのときのように脚より前（x 60）へ突き出す必要がない。
- **以前の 2 つの配置（前 45・左右 ±20 / 前 35・左右 ±15、のちの外側のフレーム板の外面）**: 最初の配置は脚の掃引域の中で取り付けられなかった。
  外側のフレーム板の外面に付ける案は成り立つが、脚の上を配線が横切り、壁から 29 mm と近すぎた。
- 左右センサの光は機体中心より 58 mm 前の壁に当たるので、区画中心で止まってから読むと、前に 26 mm 以上行き過ぎたときに次の区画の壁を見てしまう。
  そこで、**前進の途中で、光が次の区画の横壁の真ん中に当たる瞬間に横壁を読む**（ファームの `Runner::forwardOneCell`）。
- 斜めのセンサでは、横に δ ずれると光の長さは δ / sin 75° 変わる。ファームは光の長さの差に sin(向き) を掛けて横ずれにし、
  壁切れも「光が壁に当たる点」の位置で考える（`kSideLookAheadMm`）。
  以前、ファームが真横向きと決めつけていたときは、斜め（60°・75°）で柱の誤検知や衝突が起きた。直したあとは 75° で
  走行シミュレーション 16 面すべて衝突 0・誤検知 0、探索時間も真横のときと同じ。
- ファームはセンサ値を距離に換算してから制御に使うので、感度や取り付け位置が変わってもゲインの調整は要らない。
  センサ位置は `mechanism_params.h` に自動生成され、ファームとシミュレーションの両方がこの値を使う。

## 組み立て・調整手順

機構の組み立て（脚の重ね方・モジュールのつなぎ方）は [assembly.md](assembly.md)。

1. `cad/parts.scad` で部品を出力（`PART` を切り替え）。脚 1 本あたり: バー j, k, c, f 各 1、上三角形 1、足三角形 1。
   後脚は同じ部品を裏返して使う。機体の部品は `bridge`・`motor_clamp`・`sensor_holder`（STL、ホルダは黒い樹脂の光造形で 4 個）、`deck_outline`（DXF、基板の外形）。

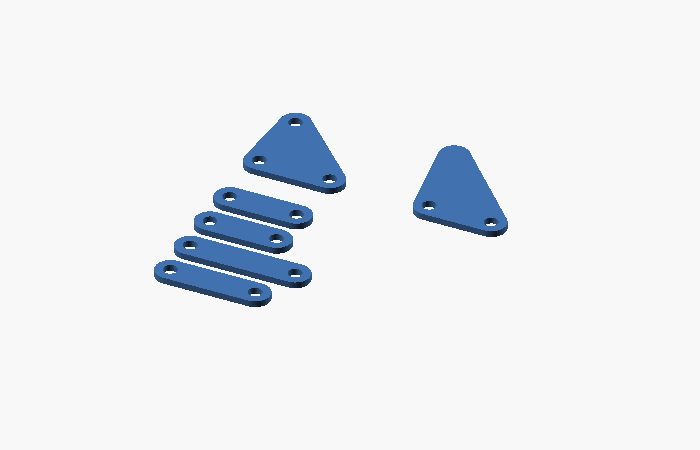
[picture p7: docs/images/parts_layout.png]
部品
   
2. 関節はガタが少なく、かつ軽く回ることを優先。組み立て後、手でクランクを回して全姿勢で引っ掛かりがないか確認。
3. モード 0 で以下を確認・設定する。
   - 前進方向にクランクを手で回して、左右のエンコーダが**増える**こと（逆なら `config.h` の `kMotorLSign / kMotorRSign`）。
   - 機体を左に回すとヨー角が**増える**こと。
   - 壁センサの値は `src/main.cpp` の `g_tuning`（`mouse::WallTuning`）に入れる:
     - 左右と前に壁がある区画の中央に置いたときの L / R → `side_ref_l / side_ref_r`
     - そのときの FL + FR → `front_ref_sum`
     - 壁あり / なしの中間値 → `thr_front / thr_side`
4. モード 3 で前進量の較正: 5 区画（900 mm）を歩かせ、実際の移動距離を測る。
   `kTravelCorrection *= 実測 / 900` とする。
5. 1 区画直進・90° 旋回を繰り返して PID を調整してから、モード 1 で探索。
