Tokoro0917/jansen-mouse/docs/jansen_report.md

# Jansen leg report (scale = 0.4 mm/unit, throws/side = 3)

## 歩容
- **1 回転あたりの前進量: 54.44 mm**
- 1 区画 (180 mm) あたりクランク回転数: 3.307 rev
- 1 本の足の接地区間の長さ: 21.23 mm（1 回転の前進量とは別物）
- 胴体速度 / クランク角速度: 8.04 〜 9.76 mm/rad
- 回転角に対する前進量の非線形性: 最大 0.61 mm
- 接地足の前後方向の滑り: 前進量の 17 %
- 足上げ高さ: 8.98 mm
- クランク中心の対地高さ: 36.73 mm
- 接地区間の平坦度: 0.269 mm
- 足先の x 範囲: -28.6 〜 -1.4 mm
- 片側の最小接地脚数: 2
- 胴体の上下動: 0.031 mm

## 駆動（機体 200 g, 足の摩擦係数 0.6, 関節効率 0.6）
- 直進時の片側クランクトルク: 最大 2.6 N·mm（実効 1.1）
- 超信地旋回時の片側クランクトルク: 最大 6.5 N·mm（実効 4.8）
- 必要なクランク回転数: 最短走行 500 mm/s で 551 rpm、旋回 180 deg/s で 122 rpm
- モータ（減速後）の要求（動作点ごと。回転数 +20 %）:
  - 直進 500 mm/s: 661 rpm で 2.6 N·mm（安全率 3 なら 7.8 N·mm）
  - 旋回 180 deg/s: 147 rpm で 6.5 N·mm（安全率 3 なら 19.5 N·mm）

## 採用したモータ: N20 ウォーム 6 V B45 42:1
- カタログ（6 V）: 無負荷 530 rpm、定格 390 rpm @ 5.9 N·mm、停動トルク（直線特性から）22.3 N·mm（0.23 kgf·cm）

| 電池の電圧 | 直進の最高速度（見積り / 負荷 3 倍） | 旋回負荷での回転数（負荷 3 倍） | 停動トルク / 旋回の最大トルク |
|---|---|---|---|
| 7.4 V | 537 / 424 mm/s | 189 rpm（要求 147） | 4.2 倍 |
| 8.4 V | 617 / 504 mm/s | 277 rpm（要求 147） | 4.8 倍 |

- 直進の最高速度は、見積りのトルクなら 500 mm/s を超えるが、トルクが見積りの 3 倍だと公称電圧（7.4 V）では届かない。摩擦係数・関節効率は試作で測って見直す。
- 停動電流は 0.91 A（満充電）で、DRV8835 の 1.5 A / ch 以内。

## 機体外形（干渉チェック済みの積層から算出）
- 全長（脚の掃引範囲）: 92.7 mm
- 全幅: 115.4 mm（中央部 26 mm を含む）
- 外接長方形の対角長（参考。旋回半径は下の「機体の部品配置」）: 148.0 mm
- 脚モジュール厚: 14.4 mm（脚 5 層 + クランクウェブ 2 枚 + フレーム板 1 枚, 板厚 1.5 mm, ワッシャ 0.3 mm）

## 積層順（1 モジュール = 前脚 + 後脚 ' ）

層 0 と層 N+1 はクランクウェブ（組立クランク軸）。固定ピン B / B' はフレーム板から片持ち。

| 層 | 部品 |
|---|---|
| 1 | T', k |
| 2 | U, k' |
| 3 | T, U', j |
| 4 | c, c', j' |
| 5 | f, f' |

固定ピンを立てる側: B = 層 N+1 側のフレーム板, B' = 層 N+1 側のフレーム板

## 機体の部品配置

- 部品と脚・フレームの干渉: なし
- 超信地旋回の半径: 72.6 mm（legs2L） / 壁まで 84 mm（余裕 11.4 mm）
- 部品の最低地上高: 29.7 mm
- 重量: 204 g、重心 (x, y, z) = (0.0, 0.0, 42.2) mm
- 横方向の最小支持幅（片側）: 31.8 mm → 転倒角 37°

| 部品 | x [mm] | y [mm] | z [mm] | 重量 [g] | 備考 |
|---|---|---|---|---|---|
| motor_L | -34〜7 | 0.5〜12.5 | 29.7〜43.7 | 15.0 | N20 ウォームギヤ 6 V B45 42:1 + 磁気エンコーダ（約 15 g。外形 12 x 14 x 41 は仮定、図面で確認） |
| motor_R | -34〜7 | -12.5〜-0.5 | 29.7〜43.7 | 15.0 | 同上 |
| deck | -40〜40 | -30.0〜30.0 | 64.2〜65.2 | 10.9 | 基板 80 x 60 x t1.0（壁センサの回路を含む部品 約 2 g）。ブリッジの上面にネジ止め |
| mcu | -13〜40 | 9.0〜30.0 | 65.2〜69.2 | 4.5 | Black Pill（ピンヘッダなし、直付け） |
| imu | 27〜37 | -28.0〜-18.0 | 65.2〜66.2 | 1.0 | ICM-20602 基板 |
| driver | 15〜25 | -28.0〜-18.0 | 65.2〜67.2 | 1.0 | DRV8835 基板 |
| bridge | -41〜18 | -12.5〜12.5 | 44.2〜64.2 | 7.3 | ブリッジ（PLA）。天板とタイロッドの所のリブだけ |
| holder_FL | 30〜34 | 6.0〜12.0 | 37.5〜64.2 | 0.6 | 壁センサのホルダ（黒い樹脂）+ OPV332 + SFH 229 FA |
| holder_FR | 30〜34 | -12.0〜-6.0 | 37.5〜64.2 | 0.6 | 壁センサのホルダ（黒い樹脂）+ OPV332 + SFH 229 FA |
| holder_L | 33〜40 | 0.3〜5.8 | 37.5〜64.2 | 0.6 | 壁センサのホルダ（黒い樹脂）+ OPV332 + SFH 229 FA |
| holder_R | 33〜40 | -5.8〜-0.3 | 37.5〜64.2 | 0.6 | 壁センサのホルダ（黒い樹脂）+ OPV332 + SFH 229 FA |
| battery | 6〜40 | -12.2〜5.8 | 65.2〜77.2 | 13.0 | 2S LiPo 200 mAh。重心が機体の中心に来る位置に置く |

| 壁センサ | 位置 (x, y, z) [mm] | 向き | 光路を遮るもの |
|---|---|---|---|
| FL | (34.0, 9.0, 42.0) | +0° | なし |
| FR | (34.0, -9.0, 42.0) | +0° | なし |
| L | (37.0, 5.0, 42.0) | +75° | なし |
| R | (37.0, -5.0, 42.0) | -75° | なし |
| FL(旧) | （以前の配置） | | なし |
| FR(旧) | （以前の配置） | | なし |
| L(旧) | （以前の配置） | | legs0L、legs1L、legs2L |
| R(旧) | （以前の配置） | | legs0R、legs1R、legs2R |

| 重量の内訳 | g |
|---|---|
| 脚リンク | 36.6 |
| フレーム板 | 21.8 |
| クランクウェブ | 3.0 |
| ピン・E リング | 50.0 |
| 六角シャフト・スペーサ・ネジ | 12.0 |
| 配線・コネクタ | 6.0 |
| 足のゴム | 4.8 |
| motor_L | 15.0 |
| motor_R | 15.0 |
| deck | 10.9 |
| mcu | 4.5 |
| imu | 1.0 |
| driver | 1.0 |
| bridge | 7.3 |
| holder_FL | 0.6 |
| holder_FR | 0.6 |
| holder_L | 0.6 |
| holder_R | 0.6 |
| battery | 13.0 |
| **合計** | **204** |

## リンク長 [mm]（穴中心間距離）

| link | holy number | length |
|---|---|---|
| a（フレーム） | 38.0 | 15.20 |
| b | 41.5 | 16.60 |
| c | 39.3 | 15.72 |
| d | 40.1 | 16.04 |
| e | 55.8 | 22.32 |
| f | 39.4 | 15.76 |
| g | 36.7 | 14.68 |
| h | 65.7 | 26.28 |
| i | 49.0 | 19.60 |
| j | 50.0 | 20.00 |
| k | 61.9 | 24.76 |
| l（フレーム） | 7.8 | 3.12 |
| m | 15.0 | 6.00 |
