Tokoro0917/jansen-mouse/docs/images/foot_path.png

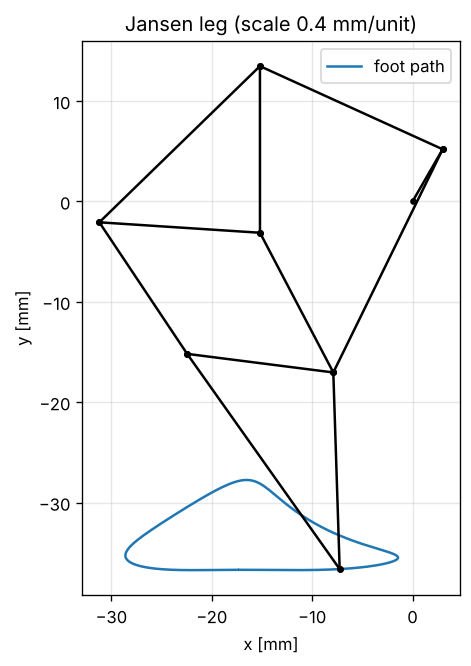
docs/images/foot_path.png
