Tokoro0917/jansen-mouse/cad/parts.scad

// テオヤンセン脚の部品（3D プリント / レーザー加工用）
// 寸法・板厚・積層順は mechanism/ から自動生成した links_generated.scad を使う。
//   python -m jansen.cli scad -o ../cad/links_generated.scad
// PART を切り替えて STL / DXF を個別に書き出せる:
//   openscad -D 'PART="layout"' -o leg_layout.stl parts.scad
include <links_generated.scad>

PART = "layout";   // layout | bar | bar_j | bar_k | bar_c | bar_f | tri_upper | tri_foot | web | web_motor | frame
                   // | coupler | bridge | motor_clamp | sensor_holder | deck_outline | none
                   // 3D プリント用（造形の向きにして床 z = 0 に置く）: print_bridge | print_motor_clamp | print_sensor_holder
// FDM の 3D プリンタは穴が小さめにできるので、穴の径をこの分だけ大きくする（例: -D FDM_CLEAR=0.2）。
// レーザー加工・光造形では 0 のまま。
FDM_CLEAR = 0;

T = PLATE;         // 板厚 [mm]
W = LINK_W;        // リンク幅 [mm]
HOLE = 3.2 + FDM_CLEAR;        // ピン穴（φ3 シャフト / M3 ネジ）
PIN_PRESS = 2.9 + FDM_CLEAR;   // クランクピン圧入穴（ウェブ側）
HEX_AF = 3.15 + FDM_CLEAR;     // 六角シャフト 3 mm（二面幅）+ 逃げ。60° 刻みで位相を変えられる
JOURNAL = 3.8 + FDM_CLEAR;     // フレーム板の軸受穴（六角シャフトの対角 3.46 mm + 逃げ）
SPACER_HOLE = 2.2 + FDM_CLEAR; // M2 スペーサ
D_HOLE = 3.1 + FDM_CLEAR;      // モータ出力軸（φ3 D カット）
$fn = 48;

module holes(pts, d = HOLE) { for (p = pts) translate(p) circle(d = d); }
module hex_hole(af) { circle(d = af / cos(30), $fn = 6); }

// 両端に穴のある直線リンク（j, k, c, f）
module bar(len) {
  linear_extrude(T) difference() {
    hull() { circle(d = W); translate([len, 0]) circle(d = W); }
    holes([[0, 0], [len, 0]]);
  }
}

// 3 辺長から三角形の第 3 頂点（原点・(s01,0) に対して）
function apex(s01, s02, s12) =
  let(x = (s02 * s02 - s12 * s12 + s01 * s01) / (2 * s01)) [x, sqrt(s02 * s02 - x * x)];

module tri_plate(s01, s02, s12, foot = false) {
  p2 = apex(s01, s02, s12);
  linear_extrude(T) difference() {
    hull() { circle(d = W); translate([s01, 0]) circle(d = W); translate(p2) circle(d = W); }
    holes(foot ? [[0, 0], [s01, 0]] : [[0, 0], [s01, 0], p2]);
  }
}

// 上三角形 B-C-E (b, d, e): B 原点, C=(b,0), E は第 3 頂点
module tri_upper() { tri_plate(L_b, L_d, L_e); }
// 足三角形 D-F-P (g, i, h): D 原点, F=(g,0), P は足先（穴なし。ゴムを貼る）
module tri_foot() { tri_plate(L_g, L_i, L_h, foot = true); }

// クランクウェブ: 組立クランク軸の腕。O に六角穴、A にクランクピン圧入穴。
// 1 モジュールに 2 枚（脚の層の両側）。モジュール間の位相は六角穴で 60° 刻みに合わせる。
// motor = true は最も内側のウェブ用で、O にモータ出力軸（φ3 D カット）を直接差し込む。
module d_hole() { intersection() { circle(d = D_HOLE); translate([-2, -1.6 - FDM_CLEAR / 2]) square([4, 4.1]); } }
module web(motor = false) {
  linear_extrude(T) difference() {
    hull() { circle(d = W + 2); translate([L_m, 0]) circle(d = W); }
    if (motor) d_hole(); else hex_hole(HEX_AF);
    translate([L_m, 0]) circle(d = PIN_PRESS);
  }
}

// フレーム板: 軸受 O、前後の脚の固定ピン B / B'（鏡像）、タイロッド（M2 全ねじ）穴
module frame() {
  linear_extrude(T) difference() {
    hull() {
      translate([-L_a, -L_l]) circle(d = W + 2);
      translate([L_a, -L_l]) circle(d = W + 2);
      circle(d = W + 4);
      for (sx = [-1, 1]) translate([sx * L_a, SPACER_Y]) circle(d = 7);
    }
    circle(d = JOURNAL);
    holes([[-L_a, -L_l], [L_a, -L_l]]);
    for (sx = [-1, 1]) translate([sx * L_a, SPACER_Y]) circle(d = SPACER_HOLE);
  }
}

// ================================================================ 機体
// 以下は機体座標（x 前, y 左, z 上。床が z = 0、クランク軸が x = 0, z = CRANK_H）で描く。
//
// 構造: 2 本の M2 全ねじ（タイロッド）が、左右すべてのフレーム板・スペーサ・ブリッジを
// (x = ±L_a, z = CRANK_H + SPACER_Y) で横に貫き、最も外側のフレーム板の外からナットで締める。
TIE_Z = CRANK_H + SPACER_Y;
DECK_HOLES = [[-L_a, -8], [-L_a, 8], [L_a, -8], [L_a, 8]];  // メイン基板 ↔ ブリッジのリブ (x, y)
CLAMP_X = [MOTOR_X[0] - 4, MOTOR_X[1] + 4];             // モータ押さえのネジ位置 (x)。モータの前後の端の外
WALL = 2.0;
TOP_T = 2.5;   // ブリッジの天板の厚さ
RIB_T = 5.0;   // タイロッドの所のリブの厚さ

// ブリッジ（3D プリント）: 左右の内側フレーム板をタイロッドでつなぎ、モータを上から押さえ、
// 上面にメイン基板をネジ止めする。天板・タイロッドの所のリブ 2 枚・モータ押さえのボス 2 本だけの形。
module bridge() {
  len = BRIDGE_X[1] - BRIDGE_X[0];
  wid = BRIDGE_Y[1] - BRIDGE_Y[0];
  hgt = BRIDGE_Z[1] - BRIDGE_Z[0];
  difference() {
    union() {
      translate([BRIDGE_X[0], BRIDGE_Y[0], BRIDGE_Z[1] - TOP_T]) cube([len, wid, TOP_T]);
      for (sx = [-1, 1]) translate([sx * L_a - RIB_T / 2, BRIDGE_Y[0], BRIDGE_Z[0]]) cube([RIB_T, wid, hgt]);
      for (x = CLAMP_X) translate([x, 0, BRIDGE_Z[0]]) cylinder(d = 6, h = hgt);
    }
    for (sx = [-1, 1]) translate([sx * L_a, BRIDGE_Y[0] - 1, TIE_Z]) rotate([-90, 0, 0]) cylinder(d = SPACER_HOLE, h = wid + 2);
    for (p = DECK_HOLES) translate([p[0], p[1], BRIDGE_Z[1] - 8]) cylinder(d = 1.8, h = 9);  // M2 タップ下穴
    for (x = CLAMP_X) translate([x, 0, BRIDGE_Z[0] - 1]) cylinder(d = 1.8, h = hgt + 2);
  }
}

// モータ押さえ（3D プリント）: 2 個のモータを下から支え、両端の柱をブリッジのボスにネジ止めする
module motor_clamp() {
  wid = BRIDGE_Y[1] - BRIDGE_Y[0];
  difference() {
    union() {
      translate([CLAMP_X[0] - 3, BRIDGE_Y[0], MOTOR_Z[0] - WALL]) cube([CLAMP_X[1] - CLAMP_X[0] + 6, wid, WALL]);
      for (x = CLAMP_X) translate([x, 0, MOTOR_Z[0] - WALL]) cylinder(d = 6, h = BRIDGE_Z[0] - MOTOR_Z[0] + WALL);
    }
    for (x = CLAMP_X) translate([x, 0, MOTOR_Z[0] - WALL - 1]) cylinder(d = 2.2 + FDM_CLEAR, h = 40);
  }
}


// メイン基板の外形（2D。基板 CAD に読み込む DXF 用）。壁センサは前端より内側の裏に下げるので、前に突き出す所はない
module deck_outline() {
  difference() {
    translate([DECK_X[0], DECK_Y[0]]) square([DECK_X[1] - DECK_X[0], DECK_Y[1] - DECK_Y[0]]);
    holes(DECK_HOLES, d = 2.2);
    // 壁センサのホルダのほぞの穴 3.2 x 3.2
    for (s = SENSORS) translate([s[0], s[1]]) rotate(s[2]) translate([-HOLDER[1] + 1.5, 0]) square([3.2, 3.2], center = true);
  }
}

// モータ軸（N20: φ3 D カット）→ 六角シャフト 3 mm の継手（web_motor を使えば不要。予備）
module coupler() {
  difference() {
    cylinder(d = 8, h = 12);
    translate([0, 0, -0.1]) linear_extrude(6.1) intersection() {
      circle(d = D_HOLE); translate([-2, -1.6 - FDM_CLEAR / 2]) square([4, 4.1]);  // D カット（平面 2.5 mm）
    }
    translate([0, 0, 6]) linear_extrude(6.1) hex_hole(HEX_AF);
  }
}

// 壁センサのホルダ（KOGUMA Mk4 / ToraNeko.Mk3 と同じ考え方。光を通さない黒い樹脂で作る）
// 基板の裏にさかさまに付ける。光は +x 向き。基板の面が z = 0、ホルダは z < 0 に下がる。
// 基板が脚の上にあるので、壁（高さ 50 mm）より下に光を出すため縦に長い（高さは HOLDER[2]）。
// 発光 OPV332 を基板から遠い穴、受光 SFH 229 FA を近い穴に後ろから差し、足を基板側に曲げて基板の穴に通す。
module sensor_holder() {
  w = HOLDER[0]; d = HOLDER[1]; hgt = HOLDER[2];
  difference() {
    union() {
      translate([-d, -w / 2, -hgt]) cube([d, w, hgt]);
      translate([-d, -1.5, 0]) cube([3.0, 3.0, 0.8]);  // ほぞ（基板の穴 3.2 x 3.2 に差す）
    }
    for (z = [HOLDER[3], HOLDER[4]]) translate([-d - 1, 0, -z]) rotate([0, 90, 0]) cylinder(d = 3.2 + FDM_CLEAR, h = d + 2);
    // 後ろの面の溝: 発光・受光の足（ピッチ 2.54）を基板まで沿わせる（足が短ければ線を継ぐ）
    for (y = [-1.27, 1.27]) translate([-d - 0.1, y - 0.6, -HOLDER[3]]) cube([1.0, 1.2, HOLDER[3] + 0.1]);
  }
}

// 4 個のホルダを機体座標に置く（基板の下面 DECK_Z[0] から下げる）
module placed_holders() {
  for (s = SENSORS) translate([s[0], s[1], DECK_Z[0]]) rotate([0, 0, s[2]]) sensor_holder();
}

if (PART == "bar") bar(L_j);
if (PART == "bar_j") bar(L_j);
if (PART == "bar_k") bar(L_k);
if (PART == "bar_c") bar(L_c);
if (PART == "bar_f") bar(L_f);
// 3D プリント用の向き
if (PART == "print_bridge")  // 天板を下にする（リブとボスが上に立つ）
  translate([0, 0, BRIDGE_Z[1]]) rotate([180, 0, 0]) bridge();
if (PART == "print_motor_clamp")  // 底板を下にする
  translate([0, 0, -(MOTOR_Z[0] - WALL)]) motor_clamp();
if (PART == "print_sensor_holder")  // 横に寝かせる（幅 6 mm の面を下に。穴は水平）
  translate([0, 0, HOLDER[0] / 2]) rotate([90, 0, 0]) sensor_holder();
if (PART == "tri_upper") tri_upper();
if (PART == "tri_foot") tri_foot();
if (PART == "web") web();
if (PART == "web_motor") web(motor = true);
if (PART == "frame") frame();
if (PART == "coupler") coupler();
if (PART == "bridge") bridge();
if (PART == "motor_clamp") motor_clamp();
if (PART == "sensor_holder") sensor_holder();
if (PART == "deck_outline") deck_outline();
if (PART == "layout") {
  // 脚 1 本分の部品一式（j, k, c, f の 4 本のバー + 三角形 2 枚）
  lens = [L_j, L_k, L_c, L_f];
  for (n = [0 : 3]) translate([0, n * (W + 3)]) bar(lens[n]);
  translate([0, 45]) tri_upper();
  translate([40, 45]) tri_foot();
}
