Tokoro0917/jansen-mouse/(commit log)

2026-10-31 テオヤンセン機構クラシックマウスのプロジェクトを作成
    - mechanism/: テオヤンセン脚の運動学シミュレーションと歩容解析 (Python, pytest)
    - firmware/: STM32F411 用ファームウェア (PlatformIO)。迷路探索(足立法)・
    制御ロジックはハード非依存にして PC 上で単体試験
    - cad/: OpenSCAD パラメトリック部品 (リンク長は自動生成)
    - docs/: 設計資料・部品表・ピン配置・解析レポート
    - CI: Python テスト、ネイティブ単体試験、実機向けビルド、生成物の差分確認
    Claude-Session: https://claude.ai/code/session_0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
    [links_generated.scad, parts.scad]
2026-10-31 機構を検証済みの 8 脚・縮尺 0.45 構成に変更し、組立 CAD を追加
    部品の積層と干渉を計算したところ、当初の 12 脚・縮尺 0.55 構成は
    全長 125 mm・全幅 175 mm 以上となり、通路 (168 mm) 内で超信地旋回
    できないことが判明したため設計を見直した。
    - mechanism/jansen/assembly.py: 1 回転分の姿勢で部品同士・ピンとの干渉を
    調べ、層数最小の積層順を探索。機体外形を算出
    - リンク j, k がクランク中心を横切るため、通し軸をやめて組立クランク軸
    (ウェブ 2 枚 + クランクピン) に変更
    - 片側 2 スロー (8 脚)・縮尺 0.45 を採用: 10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
    [assembly_generated.scad, links_generated.scad, parts.scad]
2026-10-31 1 回転あたりの前進量を修正し、駆動トルクを解析してモータ要求を決める
    1 回転あたりの前進量に「1 本の足の接地区間の長さ (23.9 mm)」を使って
    いたが、複数の脚が交代で胴体を支えるため、実際の前進量は接地足の速度
    の積分 (57.0 mm) になる。このままでは 1 区画のつもりで約 2.4 区画進む。
    - mechanism/jansen/drive.py: クランク角と胴体移動量の関係、接地足の滑り、
    直進・超信地旋回に必要なクランクトルクを計算
    - 前進量を 2 通りの方法 (速度の積分 / 接地足の位置追跡) で計算して照合
    - gait_metrics.stride を stance_le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
    [config.h, main.cpp, mechanism_params.h, motion.h]
2026-10-31 走行シミュレータを追加し、見つかった走行制御の不具合を修正
    実機と同じ走行制御・探索コードを PC 上の模擬ロボットで動かせるようにし、
    ランダム迷路で探索・最短走行を検証した。
    構成の変更:
    - 走行制御 (Motion) と探索手順 (Runner) を lib/mouse に移し、ハードウェアを
    MouseIO インターフェース越しに使うようにした (実機は src/hardware.h の HardwareIO)
    - ピン割り当てを src/pins.h に分離。壁センサの基準値は実行時の WallTuning に
    - mechanism_params.h にクランク角ごとの胴体速度表を追加 (シミュレーション用)
    シミュレー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
    [config.h, hardware.cpp, hardware.h, main.cpp, mechanism_params.h, pins.h]
2026-10-31 探索時間を短縮する (直進中は止まらない・90 mm/s・帰り道の早期終了)
    走行シミュレーションで探索に最長 886 秒かかっていたのを短縮した。
    迷路 16 面の合計で 27 % 短縮 (8555 秒 -> 6266 秒)、最長 643 秒。
    衝突・壁の誤検知は 0 のまま。
    - 直進中は止まらない: 次の区画の中心の 20 mm 手前でその区画の壁を先読みし、
    直進を続けるなら減速前に直進を延長する (Trapezoid::extend, Motion::extendStraight)。
    曲がるときだけ区画中心で止まる
    - 探索速度を 60 -> 90 mm/s (クランク 95 rpm、モータ要求の範囲内)
    - 帰り道は最短経路が確定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
2026-10-31 機体設計: 脚の掃引域を避けた部品配置と中央シャーシ、壁センサの移設
    脚がクランク 1 回転で掃引する範囲を計算したところ、以前の壁センサの配置は
    4 つとも脚の掃引域の中で、物理的に成り立たなかった。脚が占めない場所
    (中央の溝・脚より上・外側のフレーム板の外) に部品を置く機体設計を行った。
    - mechanism/jansen/body.py: 部品配置と検証 (脚・フレームとの干渉、
    壁センサの光路、超信地旋回の半径、重量・重心、横方向の転倒角)
    - 干渉なし、光路の遮りなし、旋回半径 71.4 mm、約 200 g、転倒角 37°
    - 前壁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
    [assembly_generated.scad, links_generated.scad, parts.scad]
2026-10-31 壁センサを KOGUMA Mk4 にならって作り直す
    KOGUMA Mk4 (Tokoro0917/koguma-mk4 の docs/spec.md「壁センサ」、
    mechanical/sensor_holder) を参考に、壁センサの回路・ホルダ・配置を見直した。
    - 回路: 発光 OPV332 を定電流 NJU6080 (10 mA)、受光 SFH 229 FA を OPA2354 の
    電流-電圧変換で受ける。発光は対角の 2 個ずつ (FL・R / L・FR) 交互に光らせる
    - ホルダ: 黒い樹脂、発光を基板から遠い穴・受光を近い穴、基板の裏にさかさまに
    付ける (sensor_holder())
    - 配置: 4 本を脚より前の 1 枚のセンサ基板にまとめた。FL/FR は溝の中で真正面
    (壁まで 34 mm)、L/R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
    [assembly_generated.scad, links_generated.scad, parts.scad]
2026-10-31 脚を 8 本から 12 本に増やす (片側 3 スロー・縮尺 0.40・板厚 1.5 mm)
    旋回半径を外接長方形の対角ではなく、脚・フレームの実際の形で計算し直すと、
    板厚を 2 -> 1.5 mm にすれば 12 脚が通路内で旋回できることが分かった。
    - 12 脚・縮尺 0.40・板厚 1.5 mm: 旋回半径 72.2 mm (余裕 11.8 mm、8 脚のときは
    12.6 mm)、胴体の上下動 0.65 -> 0.03 mm、前後の滑り 24 -> 17 %
    - 16 脚は板厚 1.5 mm でも余裕 3.4 mm 以下で不採用 (テストで明示)
    - 部品配置・センサの光路は変更なしで成立。重量 211 g、転倒角 35°
    - トルクは 12 脚の方が小さい (直進 2.7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
    [assembly_generated.scad, links_generated.scad]
2026-10-31 部品の説明つきの全体図（三面図と立体図）を追加
    - mechanism/jansen/drawing.py: 機体の配置データ (body.py) から、横・上・前の
    三面図に部品の番号と説明、寸法、壁センサの光、旋回円、迷路の壁を描く
    (python -m jansen.cli drawing)。OpenSCAD の組立図に色の凡例を付ける関数も追加
    - docs/images/overview_views.png, overview_3d.png を README と hardware.md に掲載
    Claude-Session: https://claude.ai/code/session_01H2ZvppznwShUKYq8g9oHTm
2026-10-31 中央シャーシを小さくする（ブリッジに置き換え、約 12 g 軽く）
    中央シャーシは溝を埋める箱（104 x 25 x 24 mm、約 19 g）で、機体の約 9 % を
    占めていた。必要な役目ごとに見直した。
    - ブリッジ: 天板 2.5 mm、タイロッドの所のリブ 2 枚、モータ押さえのボス 2 本だけ
    （約 7 g）。左右の脚群をつなぎ、モータを押さえ、メイン基板を支える
    - タイロッドの高さを 12 脚の脚の最高点（17 mm）に合わせて 25 -> 21 mm に下げ、
    フレーム板とメイン基板も下げた（高さ 81 -> 77 mm）
    - 壁センサ基板は、メイン基板の前の舌から M2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
    [assembly_generated.scad, links_generated.scad, parts.scad]
2026-10-31 基板を 1 枚にする（中央の溝の中、モータの上に置き、壁センサも同じ基板に）
    迷路の壁は高さ 50 mm（競技規定 2-2）なので壁センサの光はそれより下に出す必要があり、
    脚の上（高さ 64 mm 以上）のメイン基板と、脚の前の低い壁センサ基板の 2 枚に分かれていた。
    基板 1 枚を、脚が入らない中央の溝の中、モータのすぐ上（高さ 44 mm）に置き、
    KOGUMA Mk4 と同じく壁センサを基板の裏に下げる（光の高さ 38.8 mm）。
    - 基板 110 x 25 mm。マイコンは STM32F411 を直付け（Black Pill と同じ回路にすればピン・
    ビルド設定はその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
    [assembly_generated.scad, links_generated.scad, parts.scad]
2026-10-31 設計資料の競技規定を最新版にし、全日本大会の持ち時間（5 分）を追記
    - レギュレーション適合の表を、NTF のクラシックマウス競技規定（2022-06-01 改定）と
    全日本大会の運営に関する注意事項（2024-12-07 改定）の条項番号つきで書き直した
    - 全日本大会の持ち時間は 5 分。シミュレーションの探索時間（4〜16 分）と比べて、
    課題として明記した
    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
2026-10-31 基板を脚の上に 1 枚で置き、重心を機体の中心に合わせる
    - 基板（1 枚）を脚の上に戻し、壁センサは縦長ホルダで基板下から光軸 42 mm まで下げる
    - 中央チャネル基板・スタンドオフを廃止
    - 電池位置を重心が (0, 0) になるよう解いて配置（重心 (0.0, 0.0, 42.5)）
    - 図面・3D 図に重心マーカーを追加、部品表・ドキュメントを更新
    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
    [assembly_generated.scad, links_generated.scad, parts.scad]
2026-11-01 左右の壁センサを斜め前 75° にして、基板の前の舌をなくす
    - 4 本の壁センサを基板の前端（x 30〜40）より内側の裏に下げる。FL / FR は ±9 mm で真正面、
    L / R は内側（±5 mm）から斜め前 75° に向け、FL / FR のホルダの前を通して横の壁を見る
    - 基板の前の舌（24 × 25 mm）を廃止。全長 110 → 93 mm（脚で決まる）
    - ファーム: 横ずれは光の長さの差 × sin(向き)、壁切れ・横壁の読み取りは光が壁に当たる点（kSideLookAheadMm）で考える
    - 電池が基板からはみ出さないよう IMU を前へ移す（重心は (0.0, 0.0, 42.3) のまま）
    - 走行シミ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
    [assembly_generated.scad, links_generated.scad, parts.scad]
2026-11-02 モータを N20 ウォームギヤ 6 V 42:1 に決め、最短走行を 500 mm/s にする
    - drive.py にモータの直線トルク-回転数モデル（MotorSpec）を追加。レポートに 2S での最高速度
    （見積り 537 mm/s / トルク 3 倍で 424 mm/s）と、旋回の余裕を出す
    - ファーム: 減速比 42、kMaxCrankRps 10.9、最短走行 500 mm/s、加速度 1500 mm/s²
    - モータ 15 g に合わせて電池が基板からはみ出さないよう、マイコンを前へ移す（重心は機体の中心のまま）
    - 走行シミュレーション 16 面: 衝突 0・誤検知 0。最短走行の合計 2077 → 1180 秒、探索 7269 → 6786 秒
    - 部品表・設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
    [assembly_generated.scad]
2026-11-02 立体図・組立図を更新（マイコンの位置変更）
    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
2026-11-02 3D プリントで試作するための STL 書き出しと手順を追加
    - parts.scad: リンク 4 種（bar_j / k / c / f）を個別に書き出せるようにし、ブリッジ・モータ押さえ・
    壁センサのホルダを造形の向きで床に置く print_* を追加。FDM 用に穴を大きくする FDM_CLEAR を追加
    - cad/export_print.sh: 1 台分の STL を cad/print/ に書き出す（数の一覧つき）
    - docs/printing.md: 部品と数、刷り方、ピンの長さ、試作の順番（脚 1 本 → 1 モジュール → 片側で速度試験 → 全体）
    - CI で新しい部品も生成を確認
    Claude-Session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
    [parts.scad]
2026-11-02 部品ごとの表と、脚どうしのつなぎ方の図を追加
    - jansen/parts_list.py（cli parts）: 板の部品（外形・穴・層・数）、3D プリント部品、関節ごとのピンの長さ・
    スリーブ・ワッシャ・E リング、軸・タイロッド・ネジを、寸法と積層順から自動で表にする（docs/parts_list.md）
    - drawing.py: 1 モジュールの関節と、部品を重ねる順番・ピンの範囲の図（docs/images/joints.png）
    - printing.md のピン表は、計算式の違う古い値だったので parts_list.md への案内に置き換え
    - CI で parts_list.md が最新かも確認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
2026-11-02 組み立て手順の図と説明を追加
    - jansen/assembly_guide.py（cli guide）: 1 モジュールをフレーム板から 1 層ずつ重ねていく手順図
    （層の間を広げた立体図、ピン・スリーブつき）と、片側 3 モジュールのつなぎ方の図を OpenSCAD で描く
    - docs/assembly.md: 準備 → 1 モジュール → 片側をつなぐ（六角シャフト 120°、タイロッド）→ 真ん中（ブリッジ・モータ・基板）
    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
2026-11-02 ピンの端の処理を部品表に入れる（外側の層を部品が通る端は面一・接着）
    1 モジュールのピンのうち B・B'・D・D'・E・E' は、片方の端のすぐ外側の層を別の部品が通るため、
    E リング（外径 6 mm 前後）やピンの出っ張りが当たる。部品表で端ごとに、クランク 1 回転 72 姿勢で
    確認して「E リング」か「面一・接着」かを決め、ピンの長さ・E リングの数をそれに合わせた
    （E リング 1 台 120 → 84 個）。どのピンにも E リングの端が 1 つ残ることをテストで確認。
    printing.md の「M3 ネジで代用」は、両端に余裕のある C・C'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
2026-11-02 買う部品を減らした試作キットを追加（3D プリント + フィラメント + 接着剤で 1 組）
    - jansen/print_kit.py（cli kit → cad/print_kit_generated.scad）: 1 組分の 17 部品
    - ワッシャ・スリーブを穴のまわりのボスにして一緒に刷る。どの部品もボスは片面だけ（平らに刷れる）。
    ボスの外径 4 mm は、積層順の確認に使った「ピン + 逃げ φ4」の範囲に収まる
    - ピンは 1.75 mm フィラメント。端は「頭（はんだごてで潰す）」か「接着（面一）」。
    頭の大きさ（半径 1.9 mm）で隣の層を通る部品を確認し、B・B'・D・D' の片端だけ面一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
    [print_kit_generated.scad]
2026-11-02 モジュール厚にフレーム板とウェブの間のワッシャを入れる（片側 3 モジュールで幅 +1.8 mm）
    実際の積層は 1 モジュールあたり
    フレーム板 | w | ウェブ | w | 脚 1 | ... | 脚 N | w | ウェブ | w | 次のフレーム板
    でワッシャが N+3 枚あるが、モジュール厚は N+2 枚分で計算していた。
    parts_list / print_kit は正しい積層（フレーム板 = 層 -1 と N+2）を前提にしていたため、
    組立図ではフレーム板とウェブが接していた（cli.build_assembly は内側、side_scad は外側）。
    - assembly: layer_offset / module_thickness を追加し、厚さ = (N+3) × (板厚 + ワッ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
    [assembly_generated.scad]
